sarnaz/AutomaticGardening/README.md

# SmartGarden
Project using Arduino do create a self maintainance system for a plant using sensors
