sarnaz/AutomaticGardening/(list of files, drawings)

Other design files:
SmartGarden/LiquidCrystal_74HC595-1.0.0/extras/backpack.fzz
SmartGarden/LiquidCrystal_74HC595-1.0.0/extras/example.fzz
